dquadros/ATmegaDetonator/Caixa/README.md

# Projeto da Caixa do ATmegaDetonator
Desenho da caixa para corte a laser, ver informações sobre a cortadora 
em https://garoa.net.br/wiki/Laser-cutter-40w.
