dquadros/ATmegaDetonator/Esquema.pdf

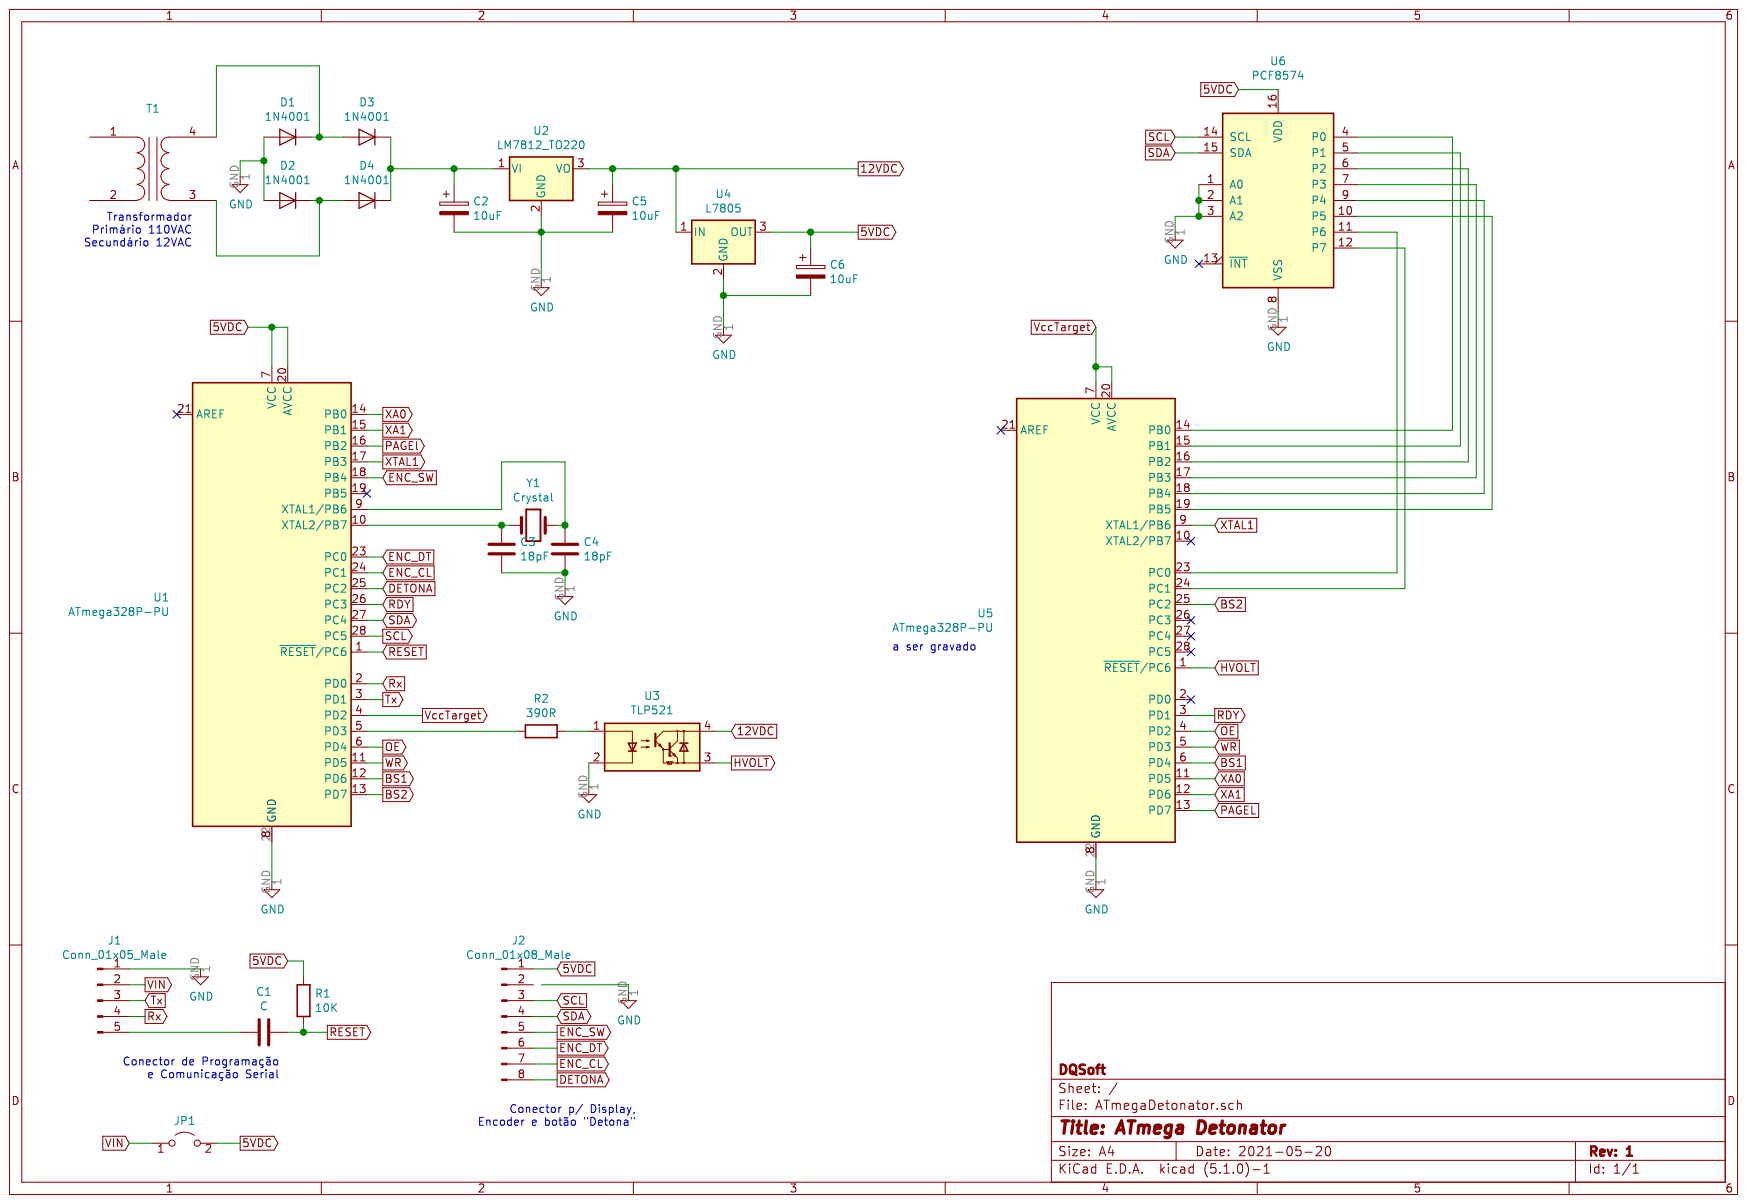
[picture p1: page 1]
