dquadros/ATmegaDetonator/(commit log)

2020-06-19 Fim da implementação do teste de conexões
2020-06-27 Acrescentados testes de leitura da identificação e dos fuses
2020-07-11 Acrescentados testes de Apagamento e Gravação da Flash e demonstração do PCF8274
2020-08-31 Incluido projeto da caixa, testa da EEProm I2C e primeira versão do firmware (Work In Progress)
    [Caixa_A.g, Caixa_B.g, Tampa_Detonator.g]
